anson-lin1/Custom-USB-Hub/USB_Hub_Schematic.kicad_pcb

## KiCad design USB_Hub_Schematic.kicad_pcb (2026-07-24)

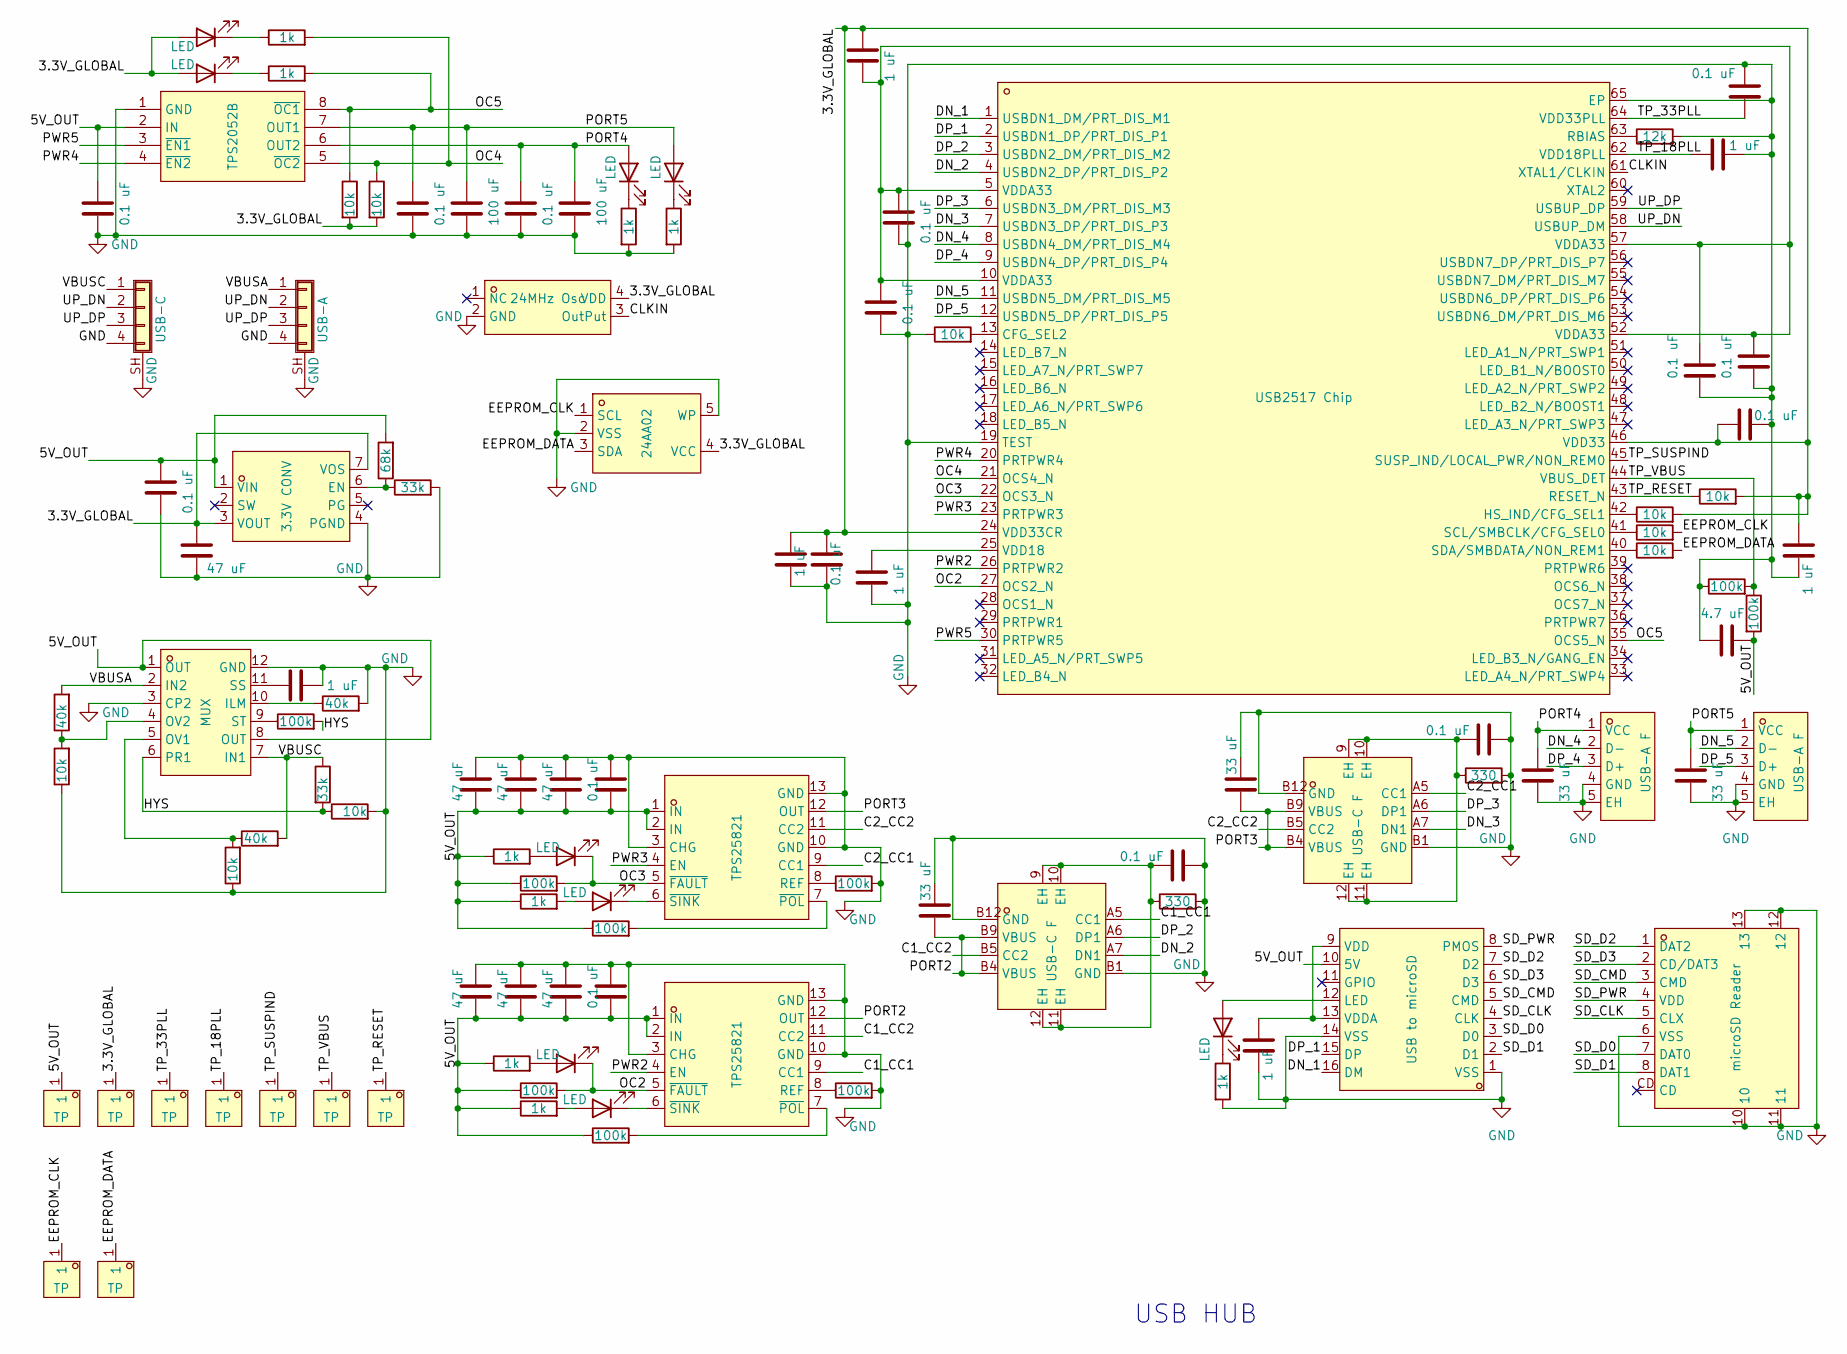
[picture p1: schematic USB_Hub_Schematic.kicad_sch]

Parts:
C1, C4, C5, C20, C22, C31, C35: 1 uF; C_0603_1608Metric; LCSC Part C15849
C2, C9, C18, C23, C24, C25, C26, C29, C32, C36, C37, C40, C41, C42, C44: 0.1 uF; C_0402_1005Metric; LCSC Part C1525
C3, C12, C13, C17, C33, C38, C39: 47 uF; C_0805_2012Metric; LCSC Part C16780
C19, C21, C30, C48: 33 uF; C_0805_2012Metric; LCSC Part C342635
C28: 4.7 uF; C_0603_1608Metric; LCSC Part C19666
C43, C45: 100 uF; C_1206_3216Metric; LCSC Part C15008
Card1: microSD Reader; TF-SMD_TF-PUSH; MPN TF PUSH; LCSC Part C393941
D2, D10, D13, D14, D15: LED; LED_0603_1608Metric; LCSC Part C2290
D11, D12, D16, D17: LED; LED_0603_1608Metric; LCSC Part C2286
J1: USB-C; SolderWire-0.1sqmm_1x04_P3.6mm_D0.4mm_OD1mm_Relief
J2: USB-A; SolderWire-0.1sqmm_1x04_P3.6mm_D0.4mm_OD1mm_Relief
R1, R2, R16, R34, R47, R49, R51, R54, R56: 100k; R_0603_1608Metric; LCSC Part C25803
R3, R4, R11, R13, R15, R27, R28, R29, R38, R41: 10k; R_0603_1608Metric; LCSC Part C177337
R5, R21, R23, R30, R31, R52, R53, R55, R57: 1k; R_0603_1608Metric; LCSC Part C177649
R6, R10: 33k; R_0603_1608Metric; LCSC Part C4216
R7: 68k; R_0603_1608Metric; LCSC Part C22356449
R9, R12, R14: 40k; R_0603_1608Metric; LCSC Part C861392
R17: 12k; R_0603_1608Metric; LCSC Part C22790
R32, R33: 330; R_0603_1608Metric; LCSC Part C23138
U1: USB2517 Chip; QFN-64_L9.0-W9.0-P0.50-BL-EP4.8; MPN USB2517-JZX; LCSC Part C1521556
U2: 3.3V CONV; QFN-7_L4.0-W3.3_TPSM863257RDXR; MPN TPSM863253RDXR; LCSC Part C30051679
U3: MUX; VQFN-HR-12_L2.5-W2.0-P0.50-BL; MPN TPS2121RUXR; LCSC Part C485916
U4: USB to microSD; SSOP-16_L4.9-W3.9-P0.64-LS6.0-BL; MPN GL823K-HCY04; LCSC Part C284879
U5: 24AA02; SOT-23-5_L2.9-W1.6-P0.95-LS2.8-BL-3; MPN 24AA02T-I/OT; LCSC Part C478090
U7: TPS2052B; SOIC-8_L4.9-W3.9-P1.27-LS6.0-BL; MPN TPS2052BD; LCSC Part C131918
U9, U10, U11, U12, U13, U14, U15, U18, U19: TP; TEST-SMD_L2.7-W1.0; MPN 5015; LCSC Part C2906768
U16, U17: TPS25821; WSON-12_L3.0-W2.0-P0.5-BL-EP; MPN TPS25821DSSR; LCSC Part C2861545
USB3, USB4: USB-C F; USB-C-SMD_MC-403L68-Z20; MPN MC-403L68-Z20; LCSC Part C47326497
USB6, USB7: USB-A F; USB-A-TH_USB-226-BRY; MPN USB-226-BRY; LCSC Part C720523
X3: 24MHz Osc; OSC-SMD_4P-L3.2-W2.5-CJ13-320001210A20; MPN OW2EL89CENUXFMYLC-24M; LCSC Part C22434893

Connections:
/3.3V_GLOBAL: C3.1, C5.1, C31.1, C32.1, C35.1, C36.1, D16.2 (A), D17.2 (A), R3.2, R4.2, R27.2, R41.2, U1.24 (VDD33CR), U1.46 (VDD33), U2.3 (VOUT), U2.7 (VOS), U5.4 (VCC), U10.1 (1_1), X3.4 (VDD)
/5V_OUT: C2.1, C12.2, C13.2, C17.2, C28.1, C33.2, C37.2, C38.2, C39.2, C40.2, C41.1, R7.2, R23.1, R34.2, R49.1, R51.1, R52.1, R53.1, R54.1, R55.1, R56.1, U2.1 (VIN), U3.1 (OUT), U3.8 (OUT), U4.10 (5V), U7.2 (IN), U9.1 (1_1), U16.1 (IN), U16.2 (IN), U17.1 (IN), U17.2 (IN)
/C1_CC1: U16.9 (CC1), USB3.A5 (CC1)
/C1_CC2: U16.11 (CC2), USB3.B5 (CC2)
/C2_CC1: U17.9 (CC1), USB4.A5 (CC1)
/C2_CC2: U17.11 (CC2), USB4.B5 (CC2)
/CLKIN: U1.61 (XTAL1/CLKIN), X3.3 (OutPut)
/DN_1: U1.1 (USBDN1_DM/PRT_DIS_M1), U4.16 (DM)
/DN_2: U1.4 (USBDN2_DP/PRT_DIS_P2), USB3.A7 (DN1)
/DN_3: U1.7 (USBDN3_DP/PRT_DIS_P3), USB4.A7 (DN1)
/DN_4: U1.8 (USBDN4_DM/PRT_DIS_M4), USB6.2 (D-)
/DN_5: U1.11 (USBDN5_DM/PRT_DIS_M5), USB7.2 (D-)
/DP_1: U1.2 (USBDN1_DP/PRT_DIS_P1), U4.15 (DP)
/DP_2: U1.3 (USBDN2_DM/PRT_DIS_M2), USB3.A6 (DP1)
/DP_3: U1.6 (USBDN3_DM/PRT_DIS_M3), USB4.A6 (DP1)
/DP_4: U1.9 (USBDN4_DP/PRT_DIS_P4), USB6.3 (D+)
/DP_5: U1.12 (USBDN5_DP/PRT_DIS_P5), USB7.3 (D+)
/EEPROM_CLK: R28.2, U5.1 (SCL), U18.1 (1_1)
/EEPROM_DATA: R38.2, U5.3 (SDA), U19.1 (1_1)
/HYS: R10.2, R11.1, R16.2, U3.6 (PR1)
/OC2: D11.1 (K), R51.2, U1.27 (OCS2_N), U16.5 (~FAULT)
/OC3: D12.1 (K), R54.2, U1.22 (OCS3_N), U17.5 (~FAULT)
/OC4: R4.1, R30.2, U1.21 (OCS4_N), U7.5 (~OC2)
/OC5: R3.1, R31.2, U1.35 (OCS5_N), U7.8 (~OC1)
/PORT2: C19.2, U16.12 (OUT), USB3.B4 (VBUS), USB3.B9 (VBUS)
/PORT3: C21.2, U17.12 (OUT), USB4.B4 (VBUS), USB4.B9 (VBUS)
/PORT4: C30.1, C44.1, C45.1, D14.2 (A), U7.6 (OUT2), USB6.1 (VCC)
/PORT5: C42.1, C43.1, C48.1, D15.2 (A), U7.7 (OUT1), USB7.1 (VCC)
/PWR2: U1.26 (PRTPWR2), U16.4 (EN)
/PWR3: U1.23 (PRTPWR3), U17.4 (EN)
/PWR4: U1.20 (PRTPWR4), U7.4 (~EN2)
/PWR5: U1.30 (PRTPWR5), U7.3 (~EN1)
/SD_CLK: Card1.5 (CLX), U4.4 (CLK)
/SD_CMD: Card1.3 (CMD), U4.5 (CMD)
/SD_D0: Card1.7 (DAT0), U4.3 (D0)
/SD_D1: Card1.8 (DAT1), U4.2 (D1)
/SD_D2: Card1.1 (DAT2), U4.7 (D2)
/SD_D3: Card1.2 (CD/DAT3), U4.6 (D3)
/SD_PWR: Card1.4 (VDD), U4.8 (PMOS)
/TP_18PLL: C22.1, U1.62 (VDD18PLL), U12.1 (1_1)
/TP_33PLL: C24.2, U1.64 (VDD33PLL), U11.1 (1_1)
/TP_RESET: R41.1, U1.43 (RESET_N), U15.1 (1_1)
/TP_SUSPIND: U1.45 (SUSP_IND/LOCAL_PWR/NON_REM0), U13.1 (1_1)
/TP_VBUS: R34.1, R47.2, U1.44 (VBUS_DET), U14.1 (1_1)
/UP_DN: J1.2, J2.2, U1.58 (USBUP_DM)
/UP_DP: J1.3, J2.3, U1.59 (USBUP_DP)
/VBUSA: J2.1, R14.2, U3.2 (IN2)
/VBUSC: J1.1, R10.1, R12.2, U3.7 (IN1)
GND: C1.2, C2.2, C3.2, C4.2, C5.2, C9.2, C12.1, C13.1, C17.1, C18.2, C19.1, C20.2, C21.1, C22.2, C23.2, C24.1, C25.2, C26.2, C28.2, C29.2, C30.2, C32.2, C33.1, C35.2, C36.2, C37.1, C38.1, C39.1, C40.1, C41.2, C42.2, C43.2, C44.2, C45.2, C48.2, Card1.6 (VSS), Card1.10, Card1.11, Card1.12, Card1.13, J1.4, J1.SH (Shield), J2.4, J2.SH (Shield), R1.2, R2.2, R5.2, R6.2, R9.2, R11.2, R13.1, R15.1, R17.2, R21.2, R29.1, R32.2, R33.2, R47.1, R57.2, U1.19 (TEST), U1.65 (EP), U2.4 (PGND), U3.3 (CP2), U3.12 (GND), U4.1 (VSS), U4.14 (VSS), U5.2 (VSS), U5.5 (WP), U7.1 (GND), U16.3 (CHG), U16.10 (GND), U16.13 (GND), U17.3 (CHG), U17.10 (GND), U17.13 (GND), USB3.B1 (GND), USB3.B12 (GND), USB4.B1 (GND), USB4.B12 (GND), USB6.4 (GND), USB6.5 (EH), USB7.4 (GND), USB7.5 (EH), X3.2 (GND)
unnamed: C18.1, R32.1, USB3.9 (EH), USB3.10 (EH), USB3.11 (EH), USB3.12 (EH)
unnamed: C9.1, C23.1, C25.1, C29.1, C31.2, U1.5 (VDDA33), U1.10 (VDDA33), U1.52 (VDDA33), U1.57 (VDDA33)
unnamed: C26.1, R33.1, USB4.9 (EH), USB4.10 (EH), USB4.11 (EH), USB4.12 (EH)
unnamed: D2.2 (A), U4.12 (LED)
unnamed: D2.1 (K), R5.1
unnamed: D10.2 (A), R23.2
unnamed: D10.1 (K), U16.6 (~SINK)
unnamed: D11.2 (A), R52.2
unnamed: D12.2 (A), R53.2
unnamed: D13.2 (A), R55.2
unnamed: D13.1 (K), U17.6 (~SINK)
unnamed: D14.1 (K), R21.1
unnamed: D15.1 (K), R57.1
unnamed: D16.1 (K), R31.1
unnamed: D17.1 (K), R30.1
unnamed: R29.2, U1.13 (CFG_SEL2)
unnamed: R27.1, U1.42 (HS_IND/CFG_SEL1)
unnamed: R17.1, U1.63 (RBIAS)
unnamed: R28.1, U1.41 (SCL/SMBCLK/CFG_SEL0)
unnamed: R38.1, U1.40 (SDA/SMBDATA/NON_REM1)
unnamed: C20.1, U1.25 (VDD18)
unnamed: R6.1, R7.1, U2.6 (EN)
unnamed: R9.1, U3.10 (ILM)
unnamed: R12.1, R13.2, U3.5 (OV1)
unnamed: R14.1, R15.2, U3.4 (OV2)
unnamed: C4.1, U3.11 (SS)
unnamed: R16.1, U3.9 (ST)
unnamed: C1.1, U4.9 (VDD), U4.13 (VDDA)
unnamed: R1.1, U16.8 (REF)
unnamed: R49.2, U16.7 (~POL)
unnamed: R2.1, U17.8 (REF)
unnamed: R56.2, U17.7 (~POL)

Notes on the sheet:
USB HUB

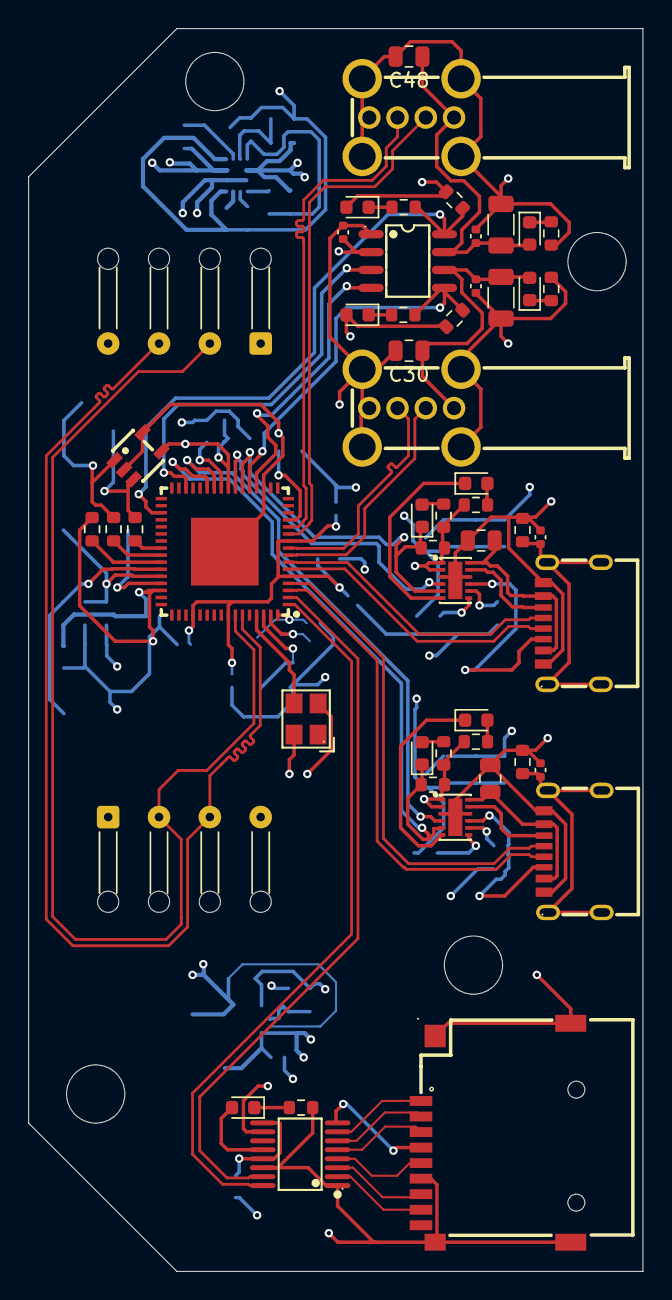
[picture p2: board USB_Hub_Schematic.kicad_pcb from above]

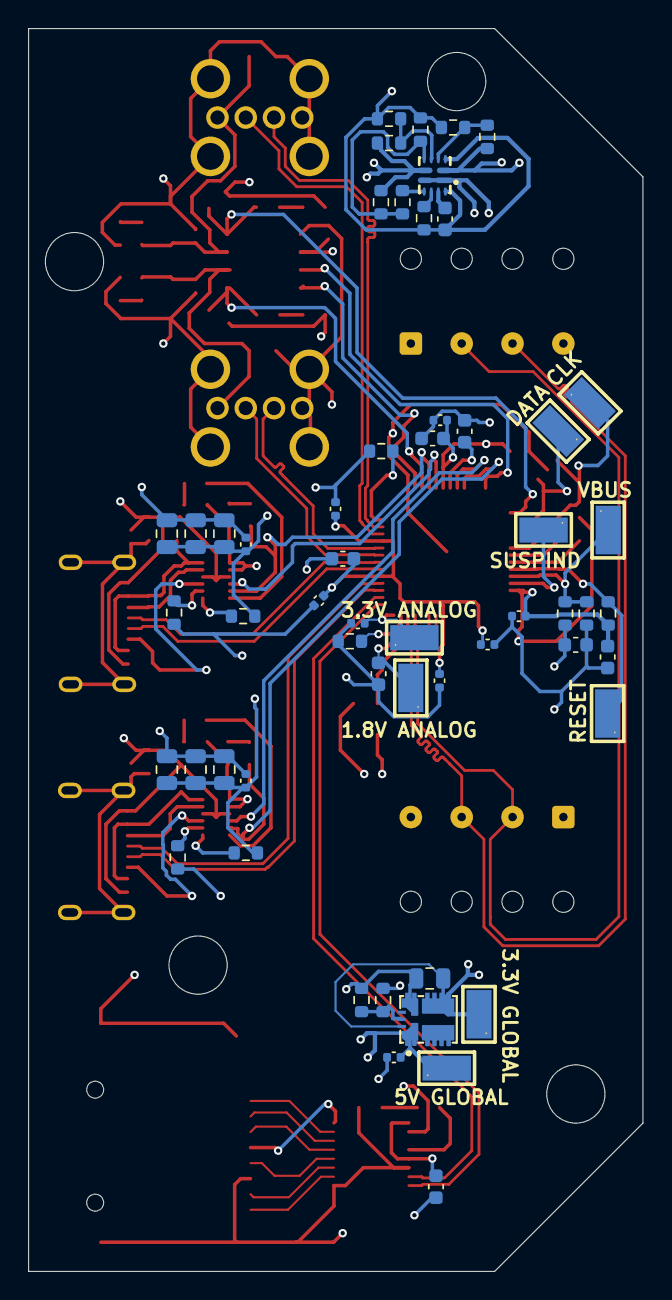
[picture p3: board USB_Hub_Schematic.kicad_pcb from below]

Board: 4 copper layers, 43.5 x 88.0 mm, 107 parts (55 on the bottom side), 81 nets.
