anson-lin1/Custom-USB-Hub/(commit log)

2026-06-24 Add PCB scripts submodule
2026-06-24 Started KiCAD
    Put all relevant ports/chips into KiCAD
    [USB_Hub_Schematic.kicad_sch]
2026-06-25 New parts
    [USB_Hub_Schematic.kicad_sch]
2026-06-26 KiCAD Work
    [USB_Hub_Schematic.kicad_sch]
2026-06-27 Continued schematics
    [USB_Hub_Schematic.kicad_sch]
2026-06-28 New schematic
    [USB_Hub_Schematic.kicad_sch]
2026-07-04 Schematic work
    [USB_Hub_Schematic.kicad_sch]
2026-07-05 Schematic draft complete
    [USB_Hub_Schematic.kicad_sch]
2026-07-11 Schematic checks
    [USB_Hub_Schematic.kicad_sch]
2026-07-14 Schematic & PCB work
    Started PCB layout
    [USB_Hub_Schematic.kicad_pcb, USB_Hub_Schematic.kicad_sch]
2026-07-15 Footprint Fix
    Reupload parts folder
    [USB_Hub_Schematic.kicad_pcb, USB_Hub_Schematic.kicad_sch]
2026-07-15 PCB Layout
    Initial layout finished, subject to routing
    [USB_Hub_Schematic.kicad_pcb, USB_Hub_Schematic.kicad_sch]
2026-07-19 More routing
    [USB_Hub_Schematic.kicad_pcb, USB_Hub_Schematic.kicad_sch]
2026-07-20 Routing continued
    [USB_Hub_Schematic.kicad_pcb, USB_Hub_Schematic.kicad_sch]
2026-07-22 Routing draft complete
    [USB_Hub_Schematic.kicad_pcb, USB_Hub_Schematic.kicad_sch]
2026-07-23 Routing Updates
    [USB_Hub_Schematic.kicad_pcb, USB_Hub_Schematic.kicad_sch]
2026-07-24 PCBWay Order Sent
    [USB_Hub_Schematic-B_Cu.gbl, USB_Hub_Schematic-B_Mask.gbs, USB_Hub_Schematic-B_Paste.gbp, USB_Hub_Schematic-B_Silkscreen.gbo, USB_Hub_Schematic-Edge_Cuts.gm1, USB_Hub_Schematic-F_Cu.gtl, USB_Hub_Schematic-F_Mask.gts, USB_Hub_Schematic-F_Paste.gtp]
